WojciechM98/Battery_Pack_Board/Battery_Pack_Board/Battery_Pack_Board.png

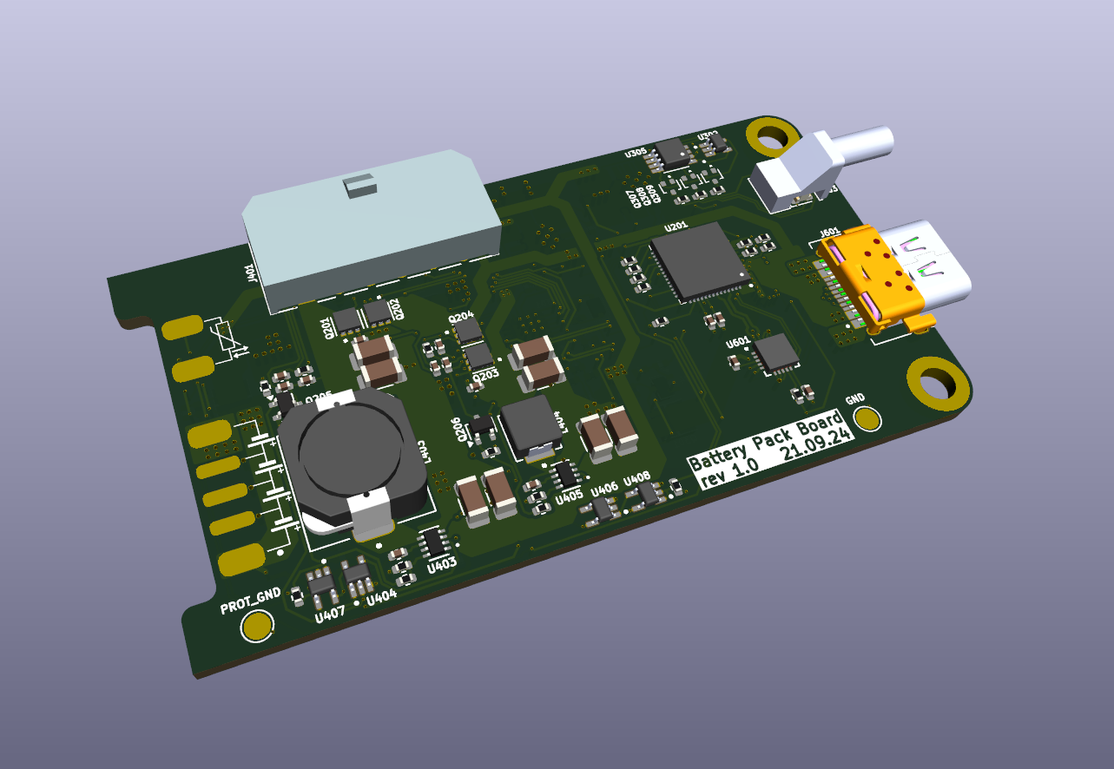
Battery_Pack_Board/Battery_Pack_Board.png
