WojciechM98/Battery_Pack_Board/Battery_Pack_Board/Battery_Pack_Board.kicad_pcb

## KiCad design Battery_Pack_Board/Battery_Pack_Board.kicad_pcb (2024-09-21)

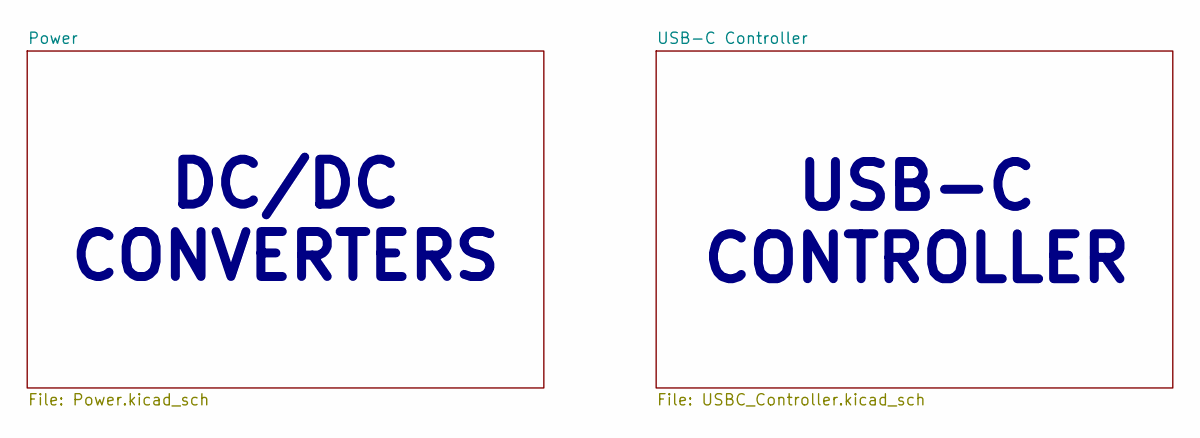
[picture p2: schematic Battery_Pack_Board.kicad_sch, Battery Pack Board]

Notes on the sheet:
DC/DC CONVERTERS
USB-C CONTROLLER

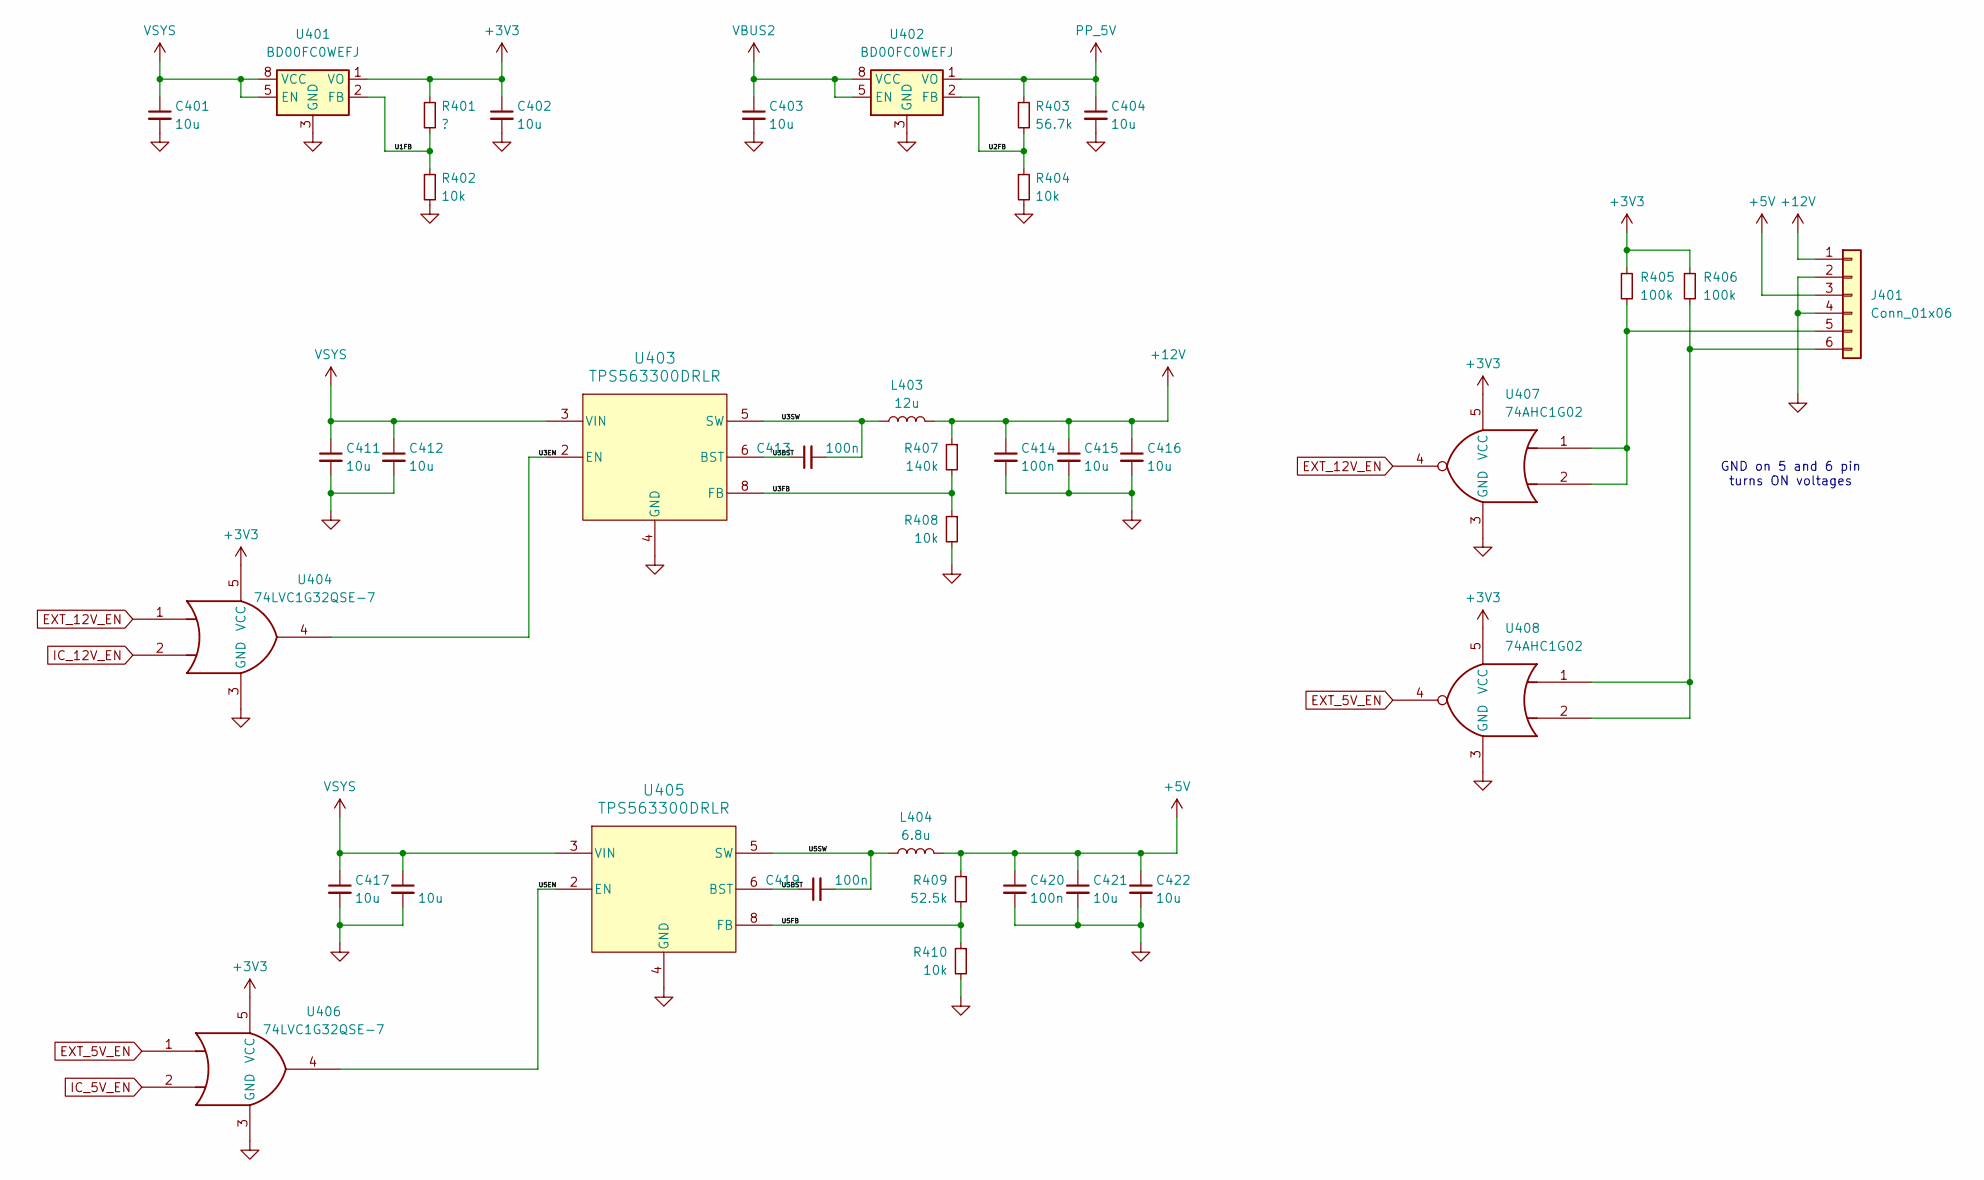
[picture p3: schematic Power.kicad_sch, Battery Pack Board]

Parts:
C401, C402, C403, C404, C411, C412, C415, C416, C417, C418, C421, C422: 10u; C_1206_3216Metric
C413, C414, C419, C420: 100n; C_0402_1005Metric
J401: Conn_01x06; 436500600
L403: 12u; SRR1050A
L404: 6.8u; SRP4020TA
R401: ?; R_0402_1005Metric
R402, R404, R408, R410: 10k; R_0402_1005Metric
R403: 56.7k; R_0402_1005Metric
R405, R406: 100k; R_0402_1005Metric
R407: 140k; R_0402_1005Metric
R409: 52.5k; R_0402_1005Metric
U401, U402: BD00FC0WEFJ; HTSOP-8-1EP_3.9x4.9mm_P1.27mm_EP2.4x3.2mm
U403, U405: TPS563300DRLR; SOT583_DRL
U404, U406: 74LVC1G32QSE-7; SOT65P210X110-5N_SOT-353
U407, U408: 74AHC1G02; SOT65P210X110-5N_SOT-353

Connections:
+3V3: C402.1, R401.1, R405.1, R406.1, U401.1 (VO), U404.5 (VCC), U406.5 (VCC), U407.5 (VCC), U408.5 (VCC); also elsewhere on the board
+5V: C420.1, C421.1, C422.1, J401.3, L404.2, R409.1; also elsewhere on the board
+12V: C414.1, C415.1, C416.1, J401.1, L403.2, R407.1; also elsewhere on the board
/Power/U1FB: R401.2, R402.1, U401.2 (FB)
/Power/U2FB: R403.2, R404.1, U402.2 (FB)
/Power/U3BST: C413.1, U403.6 (BST)
/Power/U3EN: U403.2 (EN), U404.4
/Power/U3FB: R407.2, R408.1, U403.8 (FB)
/Power/U3SW: C413.2, L403.1, U403.5 (SW)
/Power/U5BST: C419.1, U405.6 (BST)
/Power/U5EN: U405.2 (EN), U406.4
/Power/U5FB: R409.2, R410.1, U405.8 (FB)
/Power/U5SW: C419.2, L404.1, U405.5 (SW)
EXT_5V_EN: U406.1, U408.4
EXT_12V_EN: U404.1, U407.4
GND: C401.2, C402.2, C403.2, C404.2, C411.2, C412.2, C414.2, C415.2, C416.2, C417.2, C418.2, C420.2, C421.2, C422.2, J401.2, J401.4, R402.2, R404.2, R408.2, R410.2, U401.3 (GND), U401.9 (GND), U402.3 (GND), U402.9 (GND), U403.4 (GND), U404.3 (GND), U405.4 (GND), U406.3 (GND), U407.3 (GND), U408.3 (GND); also elsewhere on the board
IC_5V_EN: U406.2; also elsewhere on the board
IC_12V_EN: U404.2; also elsewhere on the board
unnamed: J401.5, R405.2, U407.1, U407.2
unnamed: J401.6, R406.2, U408.1, U408.2
PP_5V: C404.1, R403.1, U402.1 (VO); also elsewhere on the board
VBUS2: C403.1, U402.5 (EN), U402.8 (VCC); also elsewhere on the board
VSYS: C401.1, C411.1, C412.1, C417.1, C418.1, U401.5 (EN), U401.8 (VCC), U403.3 (VIN), U405.3 (VIN); also elsewhere on the board

Notes on the sheet:
GND on 5 and 6 pin turns ON voltages

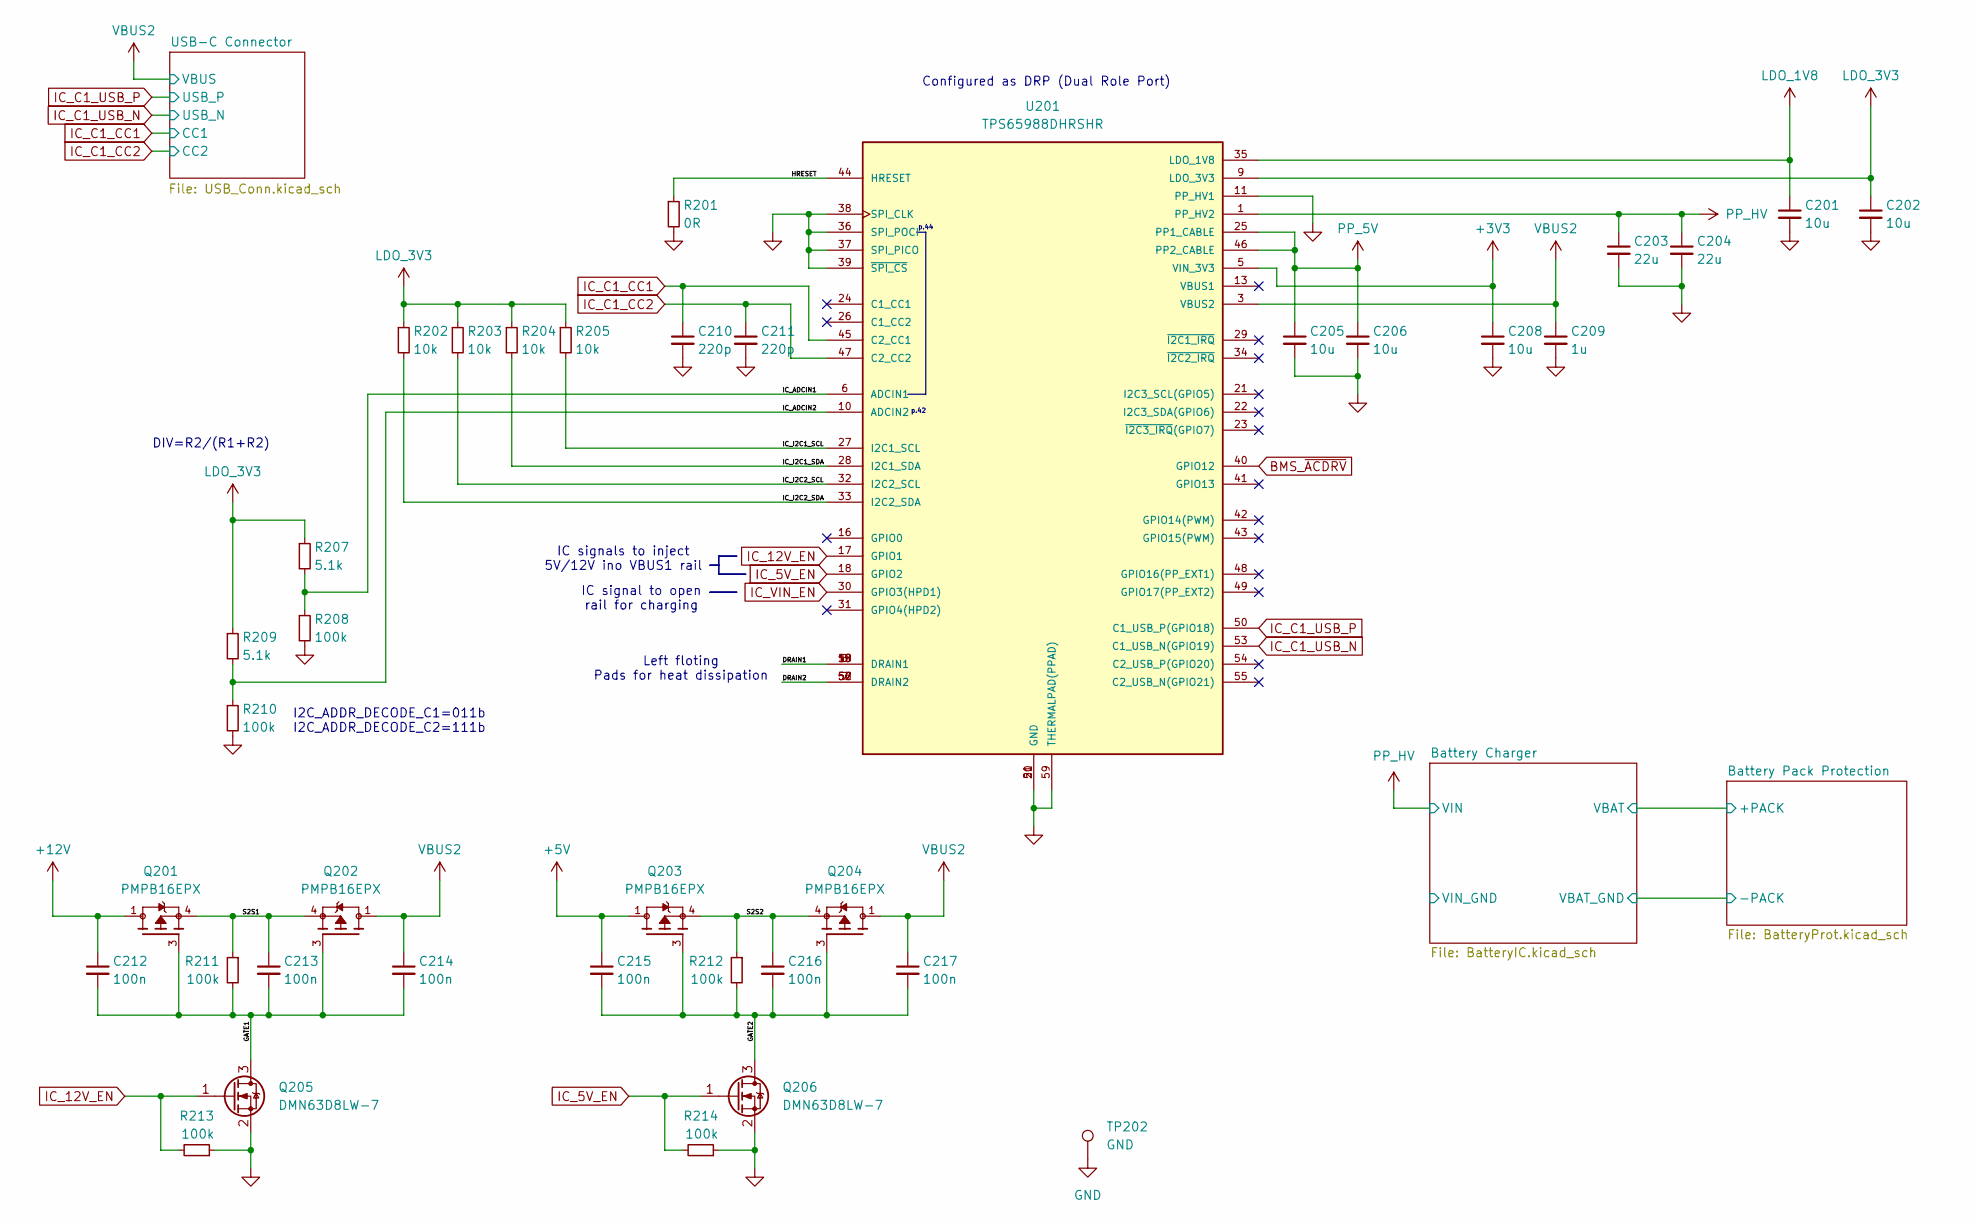
[picture p4: schematic USBC_Controller.kicad_sch, Battery Pack Board]

Parts:
C201, C202, C205, C206, C208: 10u; C_0402_1005Metric
C203, C204: 22u; C_0603_1608Metric
C209: 1u; C_0603_1608Metric
C210, C211: 220p; C_0402_1005Metric
C212, C213, C214, C215, C216, C217: 100n; C_0402_1005Metric
Q201, Q202, Q203, Q204: PMPB16EPX; PARTREV v.1
Q205, Q206: DMN63D8LW-7; SOT-323_SC-70
R201: 0R; R_0402_1005Metric
R202, R203, R204, R205: 10k; R_0402_1005Metric
R207, R209: 5.1k; R_0402_1005Metric
R208, R210, R211, R212, R213, R214: 100k; R_0402_1005Metric
TP202: GND; TestPoint_Pad_D2.0mm
U201: TPS65988DHRSHR; PARTREV AUGUST 2021

Connections:
+3V3: C208.1, U201.5 (VIN_3V3); also elsewhere on the board
+5V: C215.1, Q203.1, Q203.2, Q203.5, Q203.6, Q203.7; also elsewhere on the board
+12V: C212.1, Q201.1, Q201.2, Q201.5, Q201.6, Q201.7; also elsewhere on the board
/USB-C Controller/DRAIN1: U201.8 (DRAIN1), U201.15 (DRAIN1), U201.19 (DRAIN1), U201.58 (DRAIN1)
/USB-C Controller/DRAIN2: U201.7 (DRAIN2), U201.52 (DRAIN2), U201.56 (DRAIN2), U201.57 (DRAIN2)
/USB-C Controller/GATE1: C212.2, C213.2, C214.2, Q201.3, Q202.3, Q205.3 (D), R211.2
/USB-C Controller/GATE2: C215.2, C216.2, C217.2, Q203.3, Q204.3, Q206.3 (D), R212.2
/USB-C Controller/HRESET: R201.1, U201.44 (HRESET)
/USB-C Controller/IC_ADCIN1: R207.2, R208.1, U201.6 (ADCIN1)
/USB-C Controller/IC_ADCIN2: R209.2, R210.1, U201.10 (ADCIN2)
/USB-C Controller/IC_I2C1_SCL: R205.2, U201.27 (I2C1_SCL)
/USB-C Controller/IC_I2C1_SDA: R204.2, U201.28 (I2C1_SDA)
/USB-C Controller/IC_I2C2_SCL: R203.2, U201.32 (I2C2_SCL)
/USB-C Controller/IC_I2C2_SDA: R202.2, U201.33 (I2C2_SDA)
/USB-C Controller/S2S1: C213.1, Q201.4, Q201.8, Q202.4, Q202.8, R211.1
/USB-C Controller/S2S2: C216.1, Q203.4, Q203.8, Q204.4, Q204.8, R212.1
BMS_~ACDRV: U201.40 (GPIO12); also elsewhere on the board
GND: C201.2, C202.2, C203.2, C204.2, C205.2, C206.2, C208.2, C209.2, C210.2, C211.2, Q205.2 (S), Q206.2 (S), R201.2, R208.2, R210.2, R213.1, R214.1, TP202.1, U201.11 (PP_HV1), U201.12 (PP_HV1), U201.20 (GND), U201.36 (SPI_POCI), U201.37 (SPI_PICO), U201.38 (SPI_CLK), U201.39 (~SPI_CS), U201.51 (GND), U201.59 (THERMALPAD(PPAD)); also elsewhere on the board
IC_5V_EN: Q206.1 (G), R214.2, U201.18 (GPIO2); also elsewhere on the board
IC_12V_EN: Q205.1 (G), R213.2, U201.17 (GPIO1); also elsewhere on the board
IC_C1_CC1: C210.1, U201.45 (C2_CC1); also elsewhere on the board
IC_C1_CC2: C211.1, U201.47 (C2_CC2); also elsewhere on the board
IC_C1_USB_N: U201.53 (C1_USB_N(GPIO19)); also elsewhere on the board
IC_C1_USB_P: U201.50 (C1_USB_P(GPIO18)); also elsewhere on the board
IC_VIN_EN: U201.30 (GPIO3(HPD1)); also elsewhere on the board
LDO_1V8: C201.1, U201.35 (LDO_1V8)
LDO_3V3: C202.1, R202.1, R203.1, R204.1, R205.1, R207.1, R209.1, U201.9 (LDO_3V3)
PP_5V: C205.1, C206.1, U201.25 (PP1_CABLE), U201.46 (PP2_CABLE); also elsewhere on the board
PP_HV: C203.1, C204.1, U201.1 (PP_HV2), U201.2 (PP_HV2); also elsewhere on the board
VBUS2: C209.1, C214.1, C217.1, Q202.1, Q202.2, Q202.5, Q202.6, Q202.7, Q204.1, Q204.2, Q204.5, Q204.6, Q204.7, U201.3 (VBUS2), U201.4 (VBUS2); also elsewhere on the board

Notes on the sheet:
Left floting Pads for heat dissipation
DIV=R2/(R1+R2)
p.44
IC signals to inject 5V/12V ino VBUS1 rail
Configured as DRP (Dual Role Port)
p.42
IC signal to open rail for charging
I2C_ADDR_DECODE_C1=011b I2C_ADDR_DECODE_C2=111b

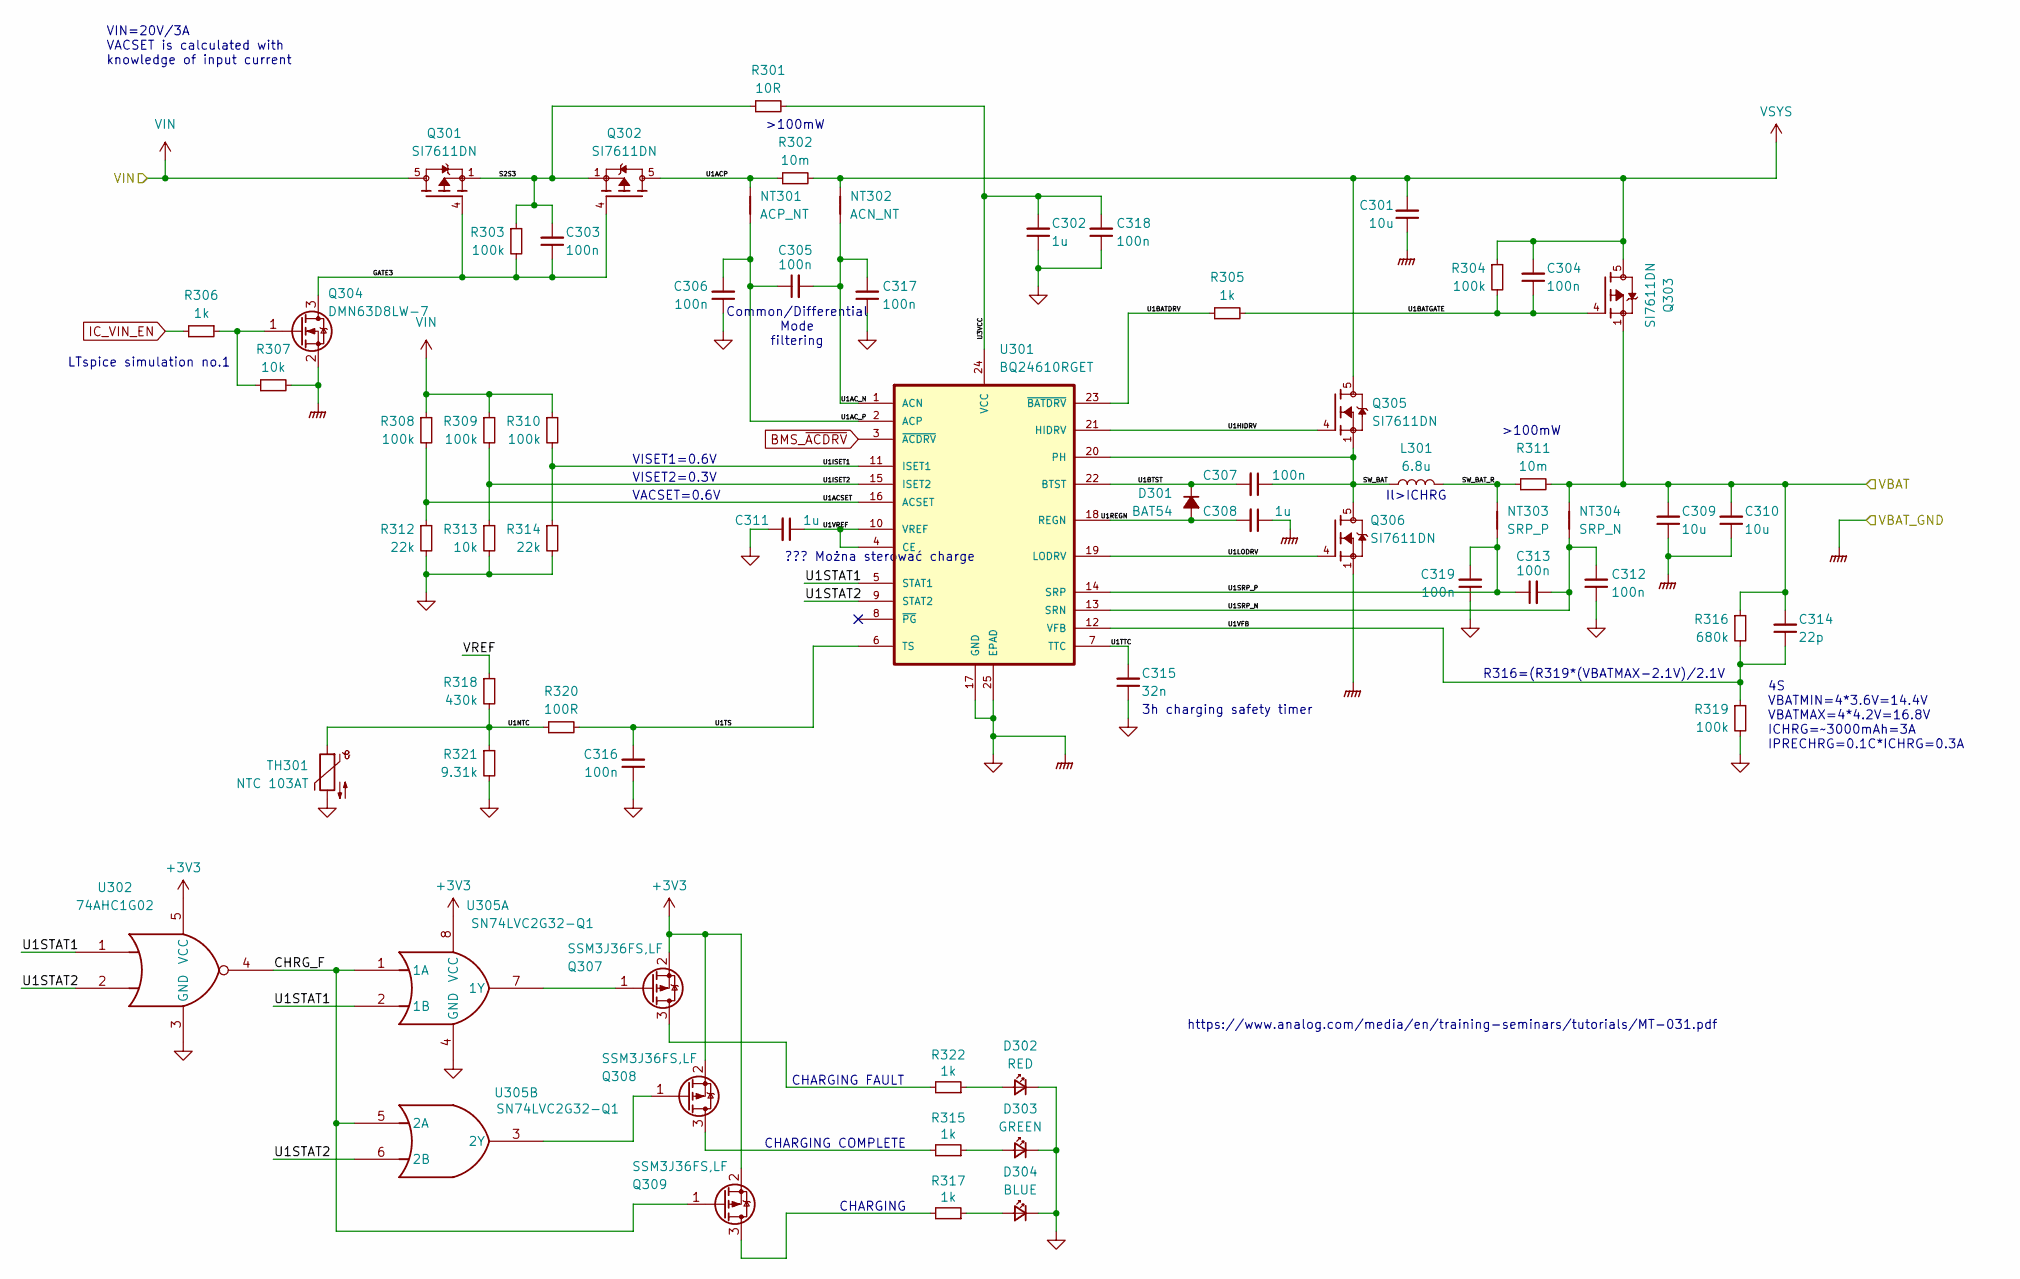
[picture p5: schematic BatteryIC.kicad_sch, Battery Pack Board]

Parts:
C301, C309, C310: 10u; C_1206_3216Metric
C302, C308, C311: 1u; C_0402_1005Metric
C303, C304, C305, C306, C307, C312, C313, C316, C317, C318, C319: 100n; C_0402_1005Metric
C314: 22p; C_0402_1005Metric
C315: 32n; C_0402_1005Metric
D301: BAT54; D_SOD-323F
D302: RED; LED_0603_1608Metric
D303: GREEN; LED_0603_1608Metric
D304: BLUE; LED_0603_1608Metric
L301: 6.8u; SRP4020TA
NT301: ACP_NT; NetTie_2_0,2mm
NT302: ACN_NT; NetTie_2_0,2mm
NT303: SRP_P; NetTie_2_0,2mm
NT304: SRP_N; NetTie_2_0,2mm
Q301, Q302, Q303: SI7611DN; VISHAY_SIS468DN-T1-GE3_SI7611DN-T1-GE3; PARTREV B
Q304: DMN63D8LW-7; SOT-323_SC-70
Q305, Q306: SI7611DN; VISHAY_SIS468DN-T1-GE3_SIS412DN-T1-GE3; PARTREV B
Q307, Q308, Q309: SSM3J36FS,LF; SOT-416
R301: 10R; R_0402_1005Metric
R302, R311: 10m; R_0805_2012Metric
R303, R304, R308, R309, R310, R319: 100k; R_0402_1005Metric
R305, R306, R315, R317, R322: 1k; R_0402_1005Metric
R307, R313: 10k; R_0402_1005Metric
R312, R314: 22k; R_0402_1005Metric
R316: 680k; R_0402_1005Metric
R318: 430k; R_0402_1005Metric
R320: 100R; R_0402_1005Metric
R321: 9.31k; R_0402_1005Metric
TH301: NTC 103AT; NTC_103AT
U301: BQ24610RGET; QFN50P400X400X100-25N
U302: 74AHC1G02; SOT65P210X110-5N_SOT-353
U305: SN74LVC2G32-Q1; SN74LVC2G32QDCURQ1

Connections:
+3V3: Q307.2 (S), Q308.2 (S), Q309.2 (S), U302.5 (VCC), U305.8 (VCC); also elsewhere on the board
/USB-C Controller/Battery Charger/CHRG_F: Q309.1 (G), U302.4, U305.1 (1A), U305.5 (2A)
/USB-C Controller/Battery Charger/GATE3: C303.1, Q301.4, Q302.4, Q304.3 (D), R303.2
/USB-C Controller/Battery Charger/S2S3: C303.2, Q301.1, Q301.2, Q301.3, Q302.1, Q302.2, Q302.3, R301.1, R303.1
/USB-C Controller/Battery Charger/SW_BAT: C307.1, L301.1, Q305.1, Q305.2, Q305.3, Q306.5, Q306.6, Q306.7, Q306.8, Q306.9, U301.20 (PH)
/USB-C Controller/Battery Charger/SW_BAT_R: L301.2, NT303.2, R311.1
/USB-C Controller/Battery Charger/U1ACP: NT301.2, Q302.5, Q302.6, Q302.7, Q302.8, Q302.9, R302.1
/USB-C Controller/Battery Charger/U1ACSET: R308.2, R312.1, U301.16 (ACSET)
/USB-C Controller/Battery Charger/U1AC_N: C305.2, C317.2, NT302.1, U301.1 (ACN)
/USB-C Controller/Battery Charger/U1AC_P: C305.1, C306.2, NT301.1, U301.2 (ACP)
/USB-C Controller/Battery Charger/U1BATDRV: R305.1, U301.23 (~BATDRV)
/USB-C Controller/Battery Charger/U1BATGATE: C304.1, Q303.4, R304.2, R305.2
/USB-C Controller/Battery Charger/U1BTST: C307.2, D301.1 (K), U301.22 (BTST)
/USB-C Controller/Battery Charger/U1HIDRV: Q305.4, U301.21 (HIDRV)
/USB-C Controller/Battery Charger/U1ISET1: R310.2, R314.1, U301.11 (ISET1)
/USB-C Controller/Battery Charger/U1ISET2: R309.2, R313.1, U301.15 (ISET2)
/USB-C Controller/Battery Charger/U1LODRV: Q306.4, U301.19 (LODRV)
/USB-C Controller/Battery Charger/U1NTC: R318.2, R320.1, R321.1, TH301.1
/USB-C Controller/Battery Charger/U1REGN: C308.2, D301.2 (A), U301.18 (REGN)
/USB-C Controller/Battery Charger/U1SRP_N: C312.2, C313.2, NT304.1, U301.13 (SRN)
/USB-C Controller/Battery Charger/U1SRP_P: C313.1, C319.2, NT303.1, U301.14 (SRP)
/USB-C Controller/Battery Charger/U1STAT1: U301.5 (STAT1), U302.1, U305.2 (1B)
/USB-C Controller/Battery Charger/U1STAT2: U301.9 (STAT2), U302.2, U305.6 (2B)
/USB-C Controller/Battery Charger/U1TS: C316.2, R320.2, U301.6 (TS)
/USB-C Controller/Battery Charger/U1TTC: C315.2, U301.7 (TTC)
/USB-C Controller/Battery Charger/U1VFB: C314.1, R316.2, R319.1, U301.12 (VFB)
/USB-C Controller/Battery Charger/U1VREF: C311.1, U301.4 (CE), U301.10 (VREF)
/USB-C Controller/Battery Charger/U3VCC: C302.2, C318.2, R301.2, U301.24 (VCC)
/USB-C Controller/Battery Charger/VBAT: C309.2, C310.2, C314.2, NT304.2, Q303.1, Q303.2, Q303.3, R311.2, R316.1; also elsewhere on the board
/USB-C Controller/Battery Charger/VREF: R318.1
BMS_~ACDRV: U301.3 (~ACDRV); also elsewhere on the board
GND: C301.1, C302.1, C306.1, C308.1, C309.1, C310.1, C311.2, C312.1, C315.1, C316.1, C317.1, C318.1, C319.1, D302.1 (K), D303.1 (K), D304.1 (K), Q304.2 (S), Q306.1, Q306.2, Q306.3, R307.2, R312.2, R313.2, R314.2, R319.2, R321.2, TH301.2, U301.17 (GND), U301.25 (EPAD), U302.3 (GND), U305.4 (GND); also elsewhere on the board
IC_VIN_EN: R306.2; also elsewhere on the board
unnamed: D302.2 (A), R322.1
unnamed: D303.2 (A), R315.1
unnamed: D304.2 (A), R317.1
unnamed: Q304.1 (G), R306.1, R307.1
unnamed: Q307.3 (D), R322.2
unnamed: Q307.1 (G), U305.7 (1Y)
unnamed: Q308.3 (D), R315.2
unnamed: Q308.1 (G), U305.3 (2Y)
unnamed: Q309.3 (D), R317.2
PP_HV: Q301.5, Q301.6, Q301.7, Q301.8, Q301.9, R308.1, R309.1, R310.1; also elsewhere on the board
VSYS: C301.2, C304.2, NT302.2, Q303.5, Q303.6, Q303.7, Q303.8, Q303.9, Q305.5, Q305.6, Q305.7, Q305.8, Q305.9, R302.2, R304.1; also elsewhere on the board

Notes on the sheet:
VISET2=0.3V
??? Można sterować charge
Il>ICHRG
>100mW
https://www.analog.com/media/en/training-seminars/tutorials/MT-031.pdf
3h charging safety timer
VISET1=0.6V
Common/Differential Mode filtering
LTspice simulation no.1
CHARGING COMPLETE
R316=(R319*(VBATMAX-2.1V)/2.1V
VIN=20V/3A VACSET is calculated with knowledge of input current
CHARGING
VACSET=0.6V
4S VBATMIN=4*3.6V=14.4V VBATMAX=4*4.2V=16.8V ICHRG=~3000mAh=3A IPRECHRG=0.1C*ICHRG=0.3A
CHARGING FAULT

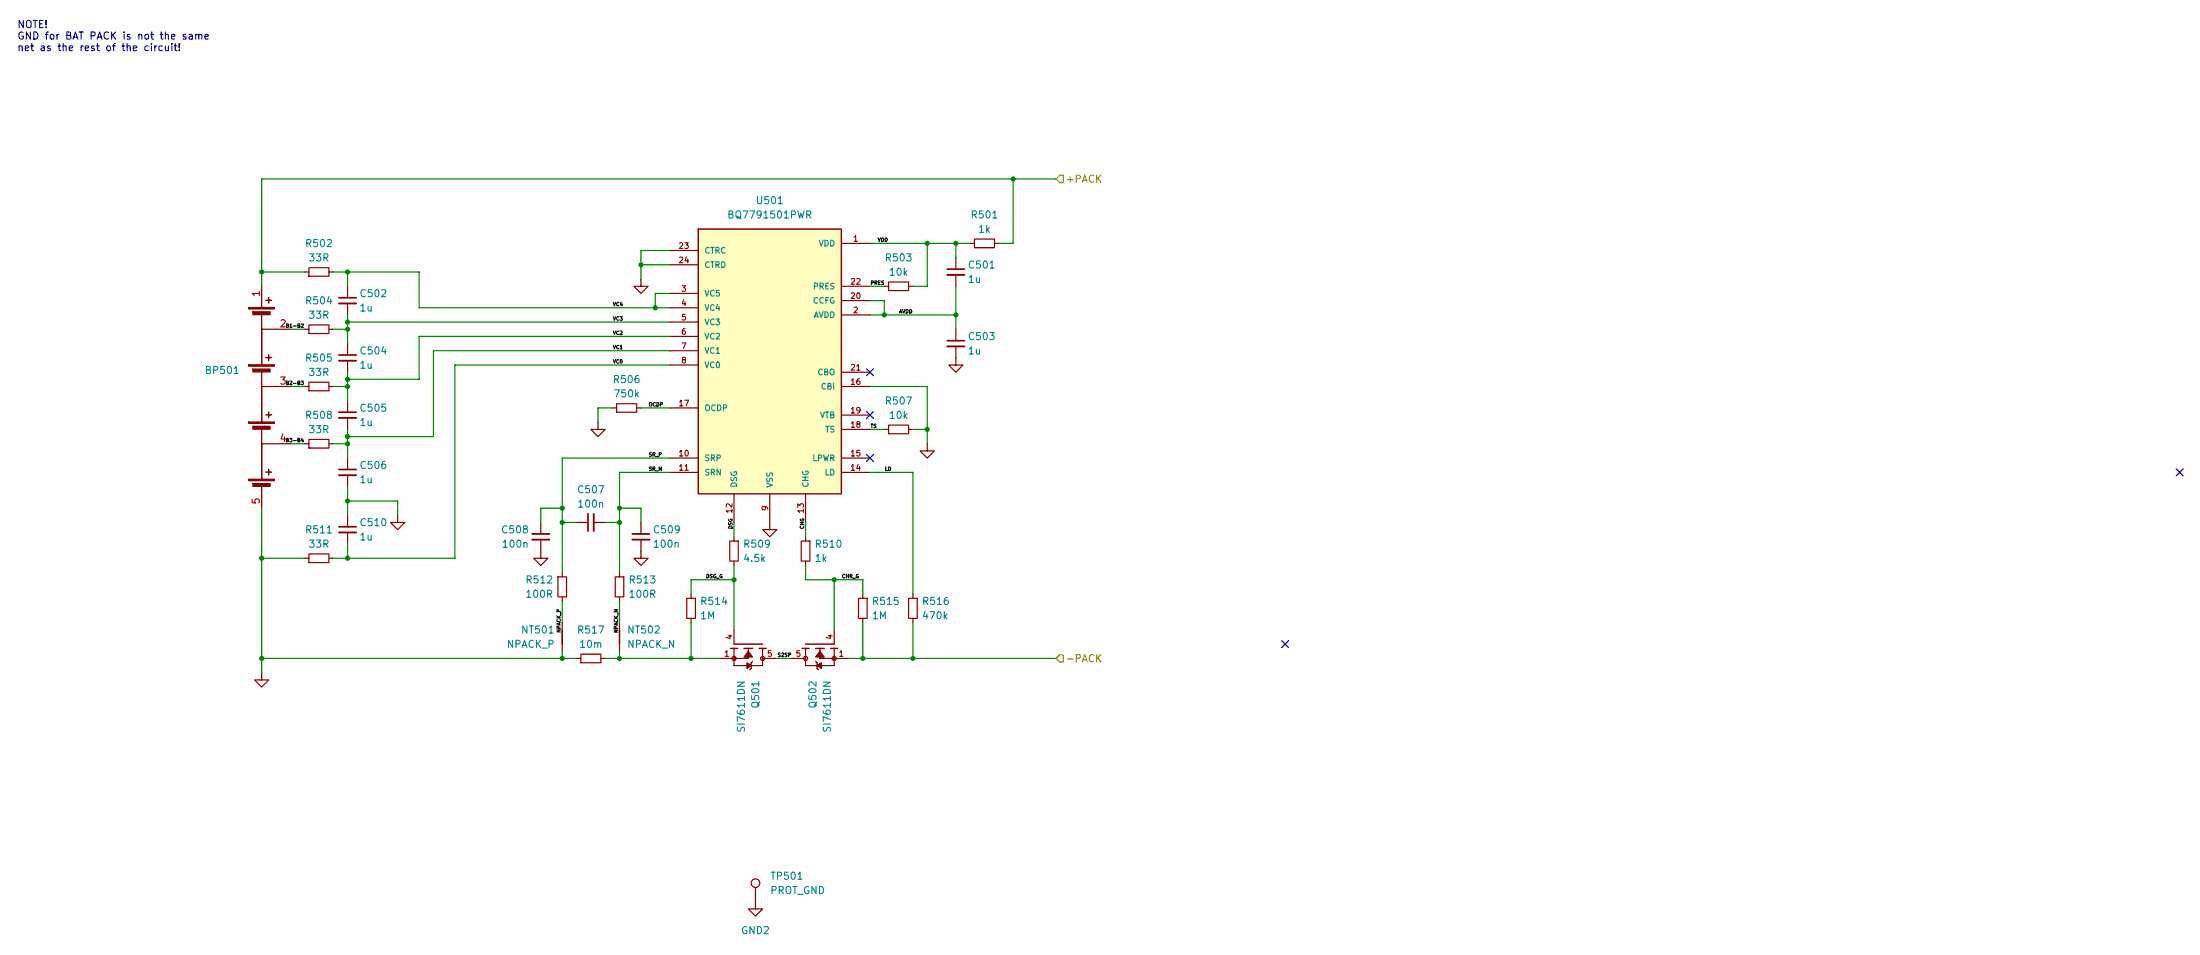
[picture p6: schematic BatteryProt.kicad_sch, Battery Pack Board]

Parts:
BP501: BatPack_4S
C501, C502, C503, C504, C505, C506, C510: 1u; C_0402_1005Metric
C507, C508, C509: 100n; C_0402_1005Metric
NT501: NPACK_P; NetTie_2_0,2mm
NT502: NPACK_N; NetTie_2_0,2mm
Q501, Q502: SI7611DN; VISHAY_SIS468DN-T1-GE3_SIS412DN-T1-GE3; PARTREV B
R501, R510: 1k; R_0402_1005Metric
R502, R504, R505, R508, R511: 33R; R_0402_1005Metric
R503, R507: 10k; R_0402_1005Metric
R506: 750k; R_0402_1005Metric
R509: 4.5k; R_0402_1005Metric
R512, R513: 100R; R_0402_1005Metric
R514, R515: 1M; R_0402_1005Metric
R516: 470k; R_0402_1005Metric
R517: 10m; R_0805_2012Metric
TP501: PROT_GND; TestPoint_Pad_D2.0mm
U501: BQ7791501PWR; SOP65P640X120-24N_BQ7791501PWR; PARTREV H

Connections:
/USB-C Controller/Battery Charger/VBAT: BP501.1, R501.2, R502.1; also elsewhere on the board
/USB-C Controller/Battery Pack Protection/AVDD: C501.2, C503.1, U501.2 (AVDD), U501.20 (CCFG)
/USB-C Controller/Battery Pack Protection/B1-B2: BP501.2, R504.1
/USB-C Controller/Battery Pack Protection/B2-B3: BP501.3, R505.1
/USB-C Controller/Battery Pack Protection/B3-B4: BP501.4, R508.1
/USB-C Controller/Battery Pack Protection/CHG: R510.1, U501.13 (CHG)
/USB-C Controller/Battery Pack Protection/CHR_G: Q502.4, R510.2, R515.1
/USB-C Controller/Battery Pack Protection/DSG: R509.1, U501.12 (DSG)
/USB-C Controller/Battery Pack Protection/DSG_G: Q501.4, R509.2, R514.1
/USB-C Controller/Battery Pack Protection/LD: R516.1, U501.14 (LD)
/USB-C Controller/Battery Pack Protection/NPACK_N: NT502.2, R513.2
/USB-C Controller/Battery Pack Protection/NPACK_P: NT501.2, R512.2
/USB-C Controller/Battery Pack Protection/OCDP: R506.2, U501.17 (OCDP)
/USB-C Controller/Battery Pack Protection/PRES: R503.1, U501.22 (PRES)
/USB-C Controller/Battery Pack Protection/S2SP: Q501.5, Q501.6, Q501.7, Q501.8, Q501.9, Q502.5, Q502.6, Q502.7, Q502.8, Q502.9
/USB-C Controller/Battery Pack Protection/SR_N: C507.2, C509.1, R513.1, U501.11 (SRN)
/USB-C Controller/Battery Pack Protection/SR_P: C507.1, C508.1, R512.1, U501.10 (SRP)
/USB-C Controller/Battery Pack Protection/TS: R507.1, U501.18 (TS)
/USB-C Controller/Battery Pack Protection/VC0: C510.2, R511.2, U501.8 (VC0)
/USB-C Controller/Battery Pack Protection/VC1: C505.2, C506.1, R508.2, U501.7 (VC1)
/USB-C Controller/Battery Pack Protection/VC2: C504.2, C505.1, R505.2, U501.6 (VC2)
/USB-C Controller/Battery Pack Protection/VC3: C502.2, C504.1, R504.2, U501.5 (VC3)
/USB-C Controller/Battery Pack Protection/VC4: C502.1, R502.2, U501.3 (VC5), U501.4 (VC4)
/USB-C Controller/Battery Pack Protection/VDD: C501.1, R501.1, R503.2, U501.1 (VDD)
GND: Q502.1, Q502.2, Q502.3, R515.2, R516.2; also elsewhere on the board
GND2: BP501.5, C503.2, C506.2, C508.2, C509.2, C510.1, NT501.1, R506.1, R507.2, R511.1, R517.1, TP501.1, U501.9 (VSS), U501.16 (CBI), U501.23 (CTRC), U501.24 (CTRD)
unnamed: NT502.1, Q501.1, Q501.2, Q501.3, R514.2, R517.2

Notes on the sheet:
NOTE! GND for BAT PACK is not the same net as the rest of the circuit!

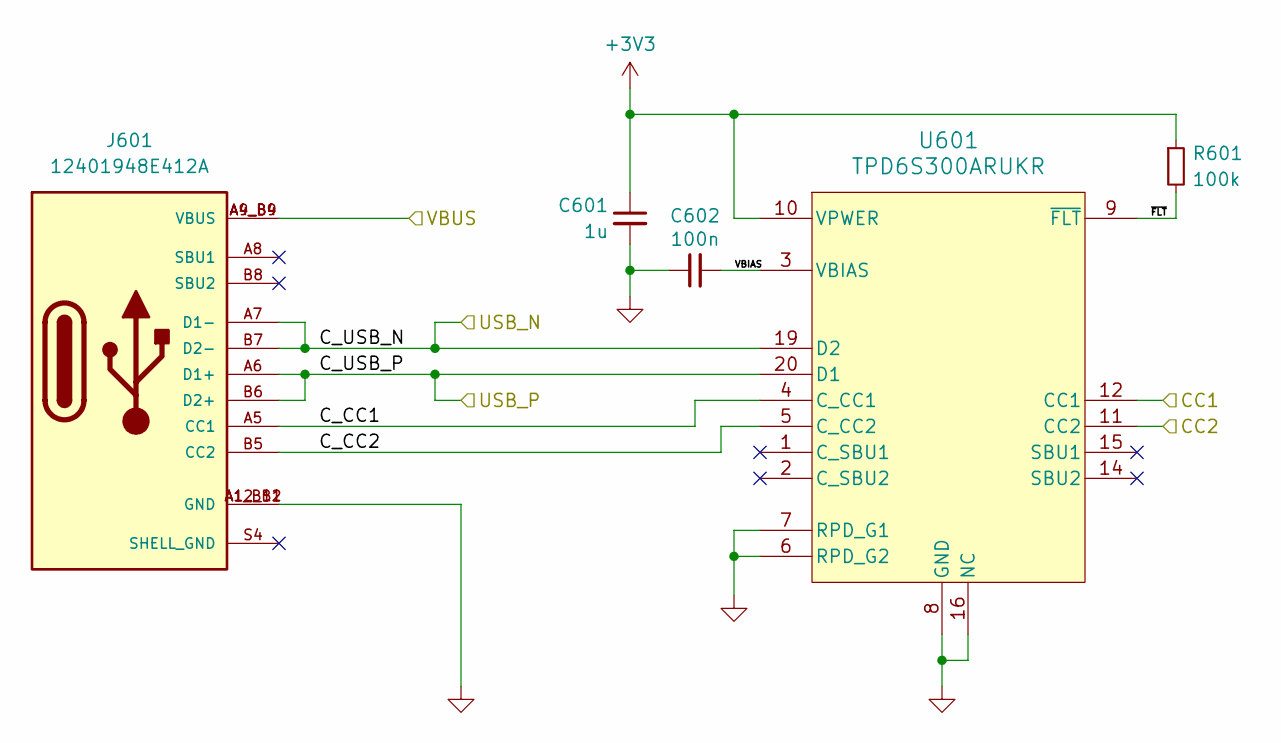
[picture p7: schematic USB_Conn.kicad_sch, Battery Pack Board]

Parts:
C601: 1u; C_0402_1005Metric
C602: 100n; C_0402_1005Metric
J601: 12401948E412A; AMPHENOL_12401948E412A; PARTREV 3
R601: 100k; R_0402_1005Metric
U601: TPD6S300ARUKR; WQFN20_RUK_TEX_TPD6S300ARUKR

Connections:
+3V3: C601.1, R601.1, U601.10 (VPWER); also elsewhere on the board
/USB-C Controller/USB-C Connector/C_CC1: J601.A5 (CC1), U601.4 (C_CC1)
/USB-C Controller/USB-C Connector/C_CC2: J601.B5 (CC2), U601.5 (C_CC2)
/USB-C Controller/USB-C Connector/VBIAS: C602.2, U601.3 (VBIAS)
/USB-C Controller/USB-C Connector/~FLT: R601.2, U601.9 (~FLT)
GND: C601.2, C602.1, J601.A1_B12 (GND), J601.A12_B1 (GND), U601.6 (RPD_G2), U601.7 (RPD_G1), U601.8 (GND), U601.13 (GND), U601.16 (NC), U601.17 (NC), U601.18 (GND), U601.21 (GND); also elsewhere on the board
IC_C1_CC1: U601.12 (CC1); also elsewhere on the board
IC_C1_CC2: U601.11 (CC2); also elsewhere on the board
IC_C1_USB_N: J601.A7 (D1-), J601.B7 (D2-), U601.19 (D2); also elsewhere on the board
IC_C1_USB_P: J601.A6 (D1+), J601.B6 (D2+), U601.20 (D1); also elsewhere on the board
VBUS2: J601.A4_B9 (VBUS), J601.A9_B4 (VBUS); also elsewhere on the board

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
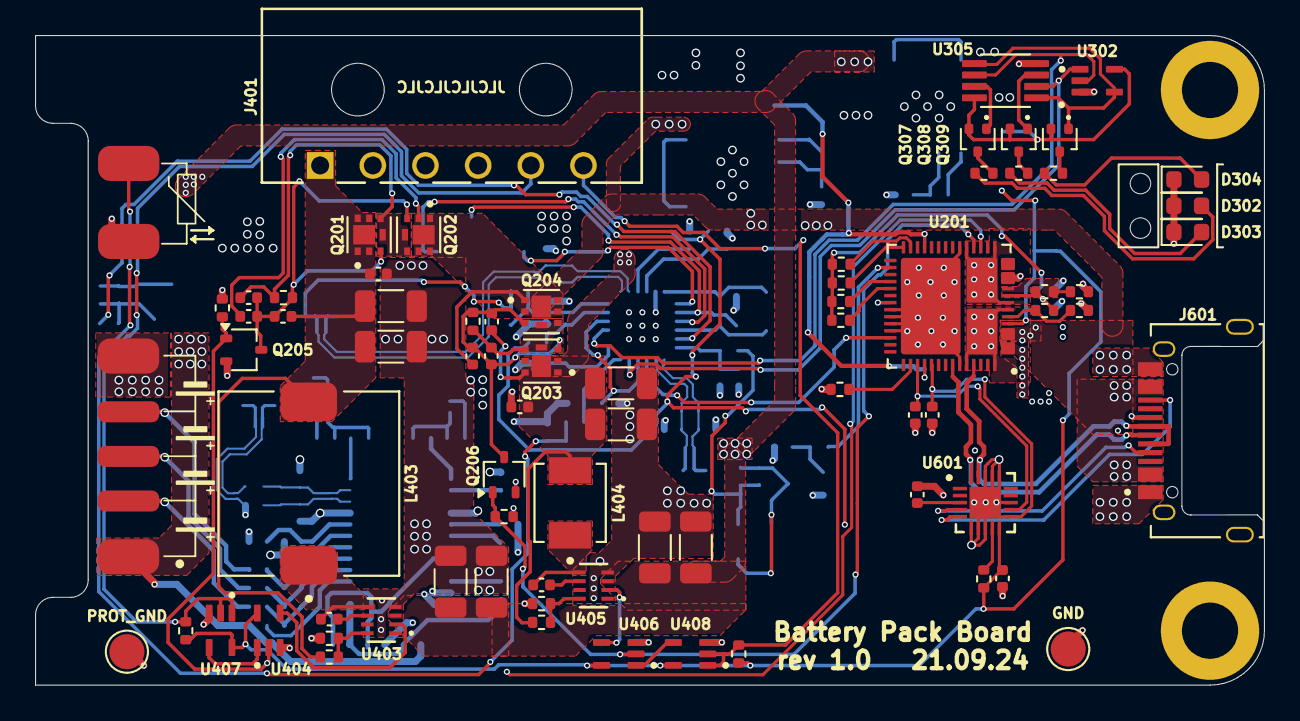
[picture p8: board Battery_Pack_Board.kicad_pcb from above]

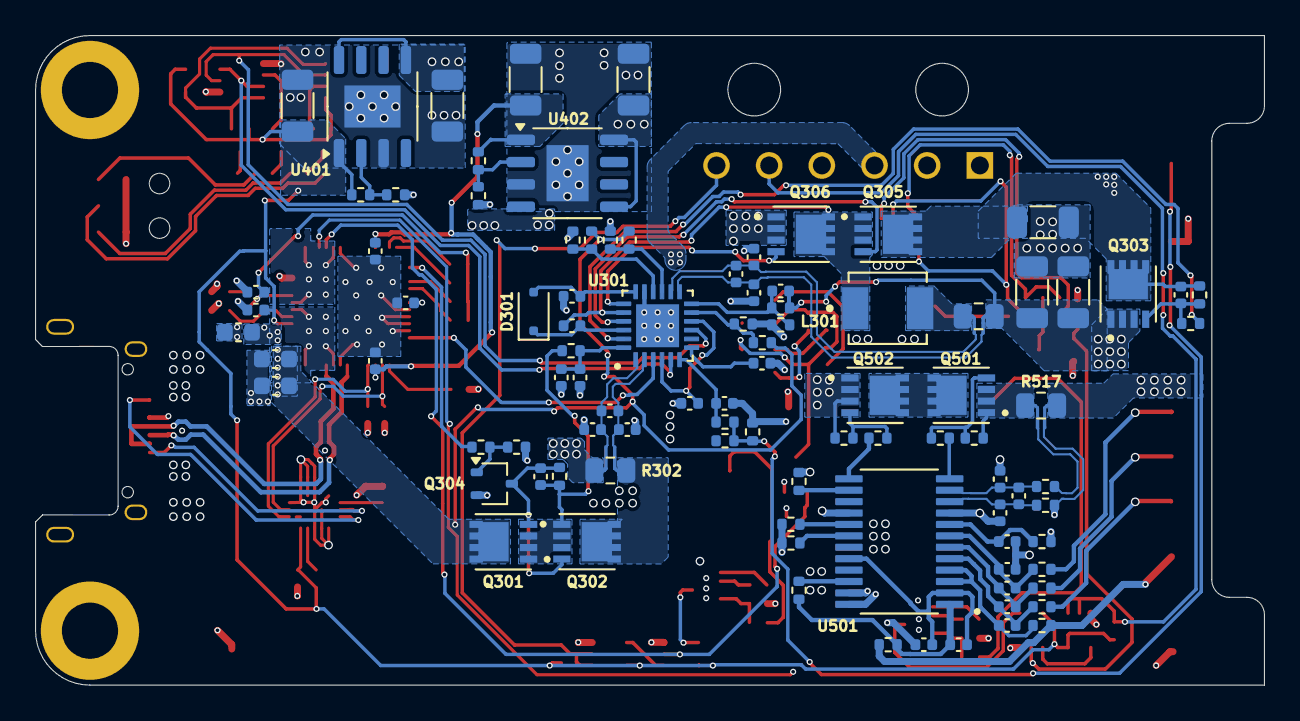
[picture p9: board Battery_Pack_Board.kicad_pcb from below]

Board: 4 copper layers, 70.0 x 37.0 mm, 176 parts (101 on the bottom side), 111 nets.
